openIE-dev/free-humanoid-platform/docs/README.md

# docs/

Additional design documentation beyond the root [README.md](../README.md) and [ARCHITECTURE.md](../ARCHITECTURE.md).

## Status (v0.0)

Stub.

## Planned content

- `building-a-free-humanoid.md` — assembly walkthrough (will be auto-generated in part by OpenLoco's `assembly.md` output, with chassis-specific augmentation)
- `commissioning.md` — first-power-on, calibration, safety supervisor verification
- `safety-and-ethics.md` — extended safety case, regulatory posture, deployment checklists
- `regulatory.md` — jurisdiction-specific notes (EU Machinery Directive, ANSI / ISO 10218, CE marking, FCC for wireless)
- `governance.md` — defensive-publication discipline, contributor norms, foundation structure (TBD)
- `release-runbook.md` — quarterly release ceremony, parallel to corpus quarterly release
- `glossary.md` — abbreviations and terms used across the platform

## License

CC-BY-SA-4.0 (per [../LICENSE-DOCS](../LICENSE-DOCS)).
