openIE-dev/free-humanoid-platform/(commit log)

2026-05-06 scaffold Free Humanoid Platform — the seventeenth OpenLoco morphology
    Initial scaffold positioning the project as the 17th morphology in the
    OpenLoco ecosystem (humanoid_bipedal). Tenant of:
    - OpenLoco — substrate (CC0 UDD descriptor → URDF/MJCF/STL/BOM)
    - Free Humanoid Corpus — 211-entry public-domain prior-art commons
    Includes:
    README.md — positioning, OpenIE family integration, license overlay
    ARCHITECTURE.md — full-system spec citing corpus entries by id;
    §9 enumerates 10 load-bearing TBD architectural calls
    descriptor/free-humanoid.udd.json
    — 40 links / 39 joints / 29 actuator slots / 4 modes,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
2026-05-07 platform: resolve 10 architectural commitments + inline canonical license texts (v0.1)
    Architectural commitments (ARCHITECTURE.md §9):
    1. Actuator distribution: HYBRID — cycloidal hip/knee, harmonic-drive
    shoulder/elbow, QDD ankle, tendon wrist+hand. Each joint shielded
    by its deepest available prior-art chain.
    2. Mass budget: 50 kg reference build. 30 kg / 80 kg as variants.
    3. Default policy: classical MPC + RL locomotion + IL manipulation.
    Full VLA documented as upgrade path.
    4. Default end-effector: 5-finger underactuated synergy-reduced hand.
    Parallel-jaw and Shadow-class as alternative variants.
    5. Depth modality: stereo + GelSight tactile fingertips. A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
2026-05-07 platform: README v0.0 → v0.1 (architectural commitments resolved, licenses inlined, corpus 230 entries)
2026-05-07 platform: hand v0.1 vendor-pinned BOM + assembly + descriptor wiring
    First Phase-1 deliverable per ARCHITECTURE.md §6: the underactuated
    5-finger synergy-reduced hand subassembly committed in §9 #4 and #8.
    Files added:
    chassis/hand-v0.1-BOM.csv — 31 line items, total ~$2,288 USD at
    unit-quantity-1 academic pricing. Real catalog numbers from Maxon,
    mjbots, Misumi, McMaster, Smooth-On, Lee Spring, Phidgets.
    chassis/hand-v0.1-assembly.md — six-phase assembly procedure with
    failure modes and calibration steps.
    chassis/hand-v0.1-cad-references.md — pointers to mechanical CAD
    files (FreeCAD .FCStd, .step, .dxf) we'll produce. ANSI Y14.5 GD&T
    + ISO 286 fits and to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
    [hand-v0.1-BOM.csv]
2026-05-07 platform: hand v0.1 OpenSCAD parametric CAD (10 .scad files)
    Parametric CAD source for the underactuated 5-finger synergy-reduced
    hand committed in §9 #4. Text-based, version-controllable, deterministic,
    renders to STL/DXF via OpenSCAD 2024.05+.
    Files at chassis/cad/:
    hand_params.scad single source of truth (dims, fits, materials,
    BOM cross-references; flags six dimensions for
    physical-build feedback)
    phalanx.scad single phalanx primitive with tendon channel,
    joint barrel, return-spring pocket
    finger.scad composes 3 phalanges (or 2 for thumb)
    palm.scad palm chassis: finger mo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
    [finger.scad, hand_assembly.scad, hand_params.scad, motor_bracket.scad, palm.scad, phalanx.scad, pulley.scad, skin_mold.scad]
2026-05-07 platform: hand v0.1 audit report + leg v0.1 BOM/assembly/OpenSCAD CAD/descriptor
    Two deliverables in one commit (audit and leg subassembly were produced
    by parallel agents).
    Hand v0.1 audit (chassis/hand-v0.1-cad-audit.md):
    Independent CAD-vs-BOM-vs-descriptor cross-check found 9 critical
    fabrication-blocking issues:
    1. Motor bracket bolts to palm at 25 mm BCD; palm has 22 mm BCD
    holes (motor_bracket.scad:30 vs palm.scad:104) — bracket cannot
    mount
    2. Finger and palm MCP barrels perpendicular after rotate([0,0,90])
    in hand_assembly.scad:58 — no shared axle
    3. motor_face_pcd=22 contradicts Maxon GP 32 HP datasheet
    (4×M3 on ~27mm PCD)
    4. 8-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
    [ankle.scad, femur.scad, foot.scad, hip.scad, knee.scad, leg-v0.1-BOM.csv, leg_assembly.scad, leg_params.scad]
2026-05-07 sim: add Genesis as secondary GPU-parallelized simulator
    Genesis (Genesis-Embodied-AI/Genesis, December 2024) is the
    GPU-parallelized open-source unified multi-physics engine published
    Apache-2.0 by a CMU/Stanford/MIT/Tsinghua/Peking/ETH/UMD academic
    collaboration. URDF/MJCF interoperable, so OpenLoco's descriptor
    compiles to it without modification. 43M FPS rigid-body on a single
    RTX 4090; differentiable for gradient-based policy optimization.
    Slotted as secondary (after MuJoCo, ahead of Drake / Gazebo / Isaac)
    because it's the open-permissive sim-to-real-at-scale substrate.
    Corpus citation links the genesis-embodied-ai-simulator entry in
    the contention-packet for control-sim-to-real.
    Co-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
2026-05-07 hand v0.1.1: address 9 critical + 6 significant audit findings
    Critical (9):
    - #1 motor_bracket <-> palm bolt circle aligned at palm_mount_pcd=25
    - #2 finger long axis rebuilt to +Y; rotate([0,0,90]) removed in
    hand_assembly; palm finger_mcp_mount and thumb_cmc_block barrels
    rotated to share an X axis with phalanx barrels
    - #3 Maxon GP 32 HP face: M3 PCD 27 (was M2.5 PCD 22); motor_bracket
    motor-side counterbore Ø5.6 for M3 head
    - #4 palm pulleys reduced from 8-star to 3 routed (spool exit + 2
    distribution); no pivot within 8 mm of motor center
    - #5 spool radius 0.004 m (was 0.008) in descriptor; ~205 N continuous
    / ~1562 N peak rationale recomputed
    - #6 MCP flex now applied to pr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
    [finger.scad, hand-v0.1-BOM.csv, hand_assembly.scad, hand_params.scad, motor_bracket.scad, palm.scad, phalanx.scad]
2026-05-07 hand v0.1.1: add build runbook (pre-order verify, vendor sequencing, 6-stage bench test)
    Closes the loop from v0.1.1 paper-fix to first physical build. Sections:
    - Pre-order verification gate (Maxon face, Misumi flange, dowel, bushing)
    - 3-tier vendor sequencing (Maxon 4-6 wk, mjbots 1-2 wk, McMaster JIT)
    - Pre-fab CAD prep with PLA desktop sanity check before SLS
    - Receive-and-inspect checklist per vendor batch
    - 6-stage bench test (motor spin -> single finger -> 5-finger manual ->
    motor synergy -> tension loop -> 24-hr cycle soak)
    - Feedback capture spec for v0.1.2 (descriptor <-> physical loop)
    - Known-risk register (audit-deferred + new physical-build risks)
    The runbook is the artif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
2026-05-07 hand v0.1.1: wire openie-cad parse+UDD verifier as the canonical CAD check
    All 9 v0.1.1 .scad files PASS via openie-cad (cad.openie.dev) check_openscad
    example: every file lexes, parses, and imports to UDD without semantic
    error. Stronger than brace/paren balancing.
    Build runbook §3.1 now calls the openie-cad verification before STL render
    as the canonical CAD-check step. The OpenSCAD render step in §3.2 is
    preserved (Homebrew openscad deprecated 2026-09-01; nightly build is
    the path until openie-cad's CSG kernel exposes a CLI render).
    hand-v0.1.1-fixes.md captures the v0.1.1 baseline result with body/UDD-
    node counts and links to the verifier source. Re-run before any future
    CAD edit; e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
2026-05-08 hand v0.1.2: address 6 deferred audit items + invariant assertions
    #12 palm routing topology validated and documented (50-line topology
    comment block + per-leg distance / wrap-angle / motor-mount
    clearance check)
    #13 palm tendon distribution channel limited from full ~90mm to actual
    ~30mm cable run — restores PA12 wall thickness in unused region
    #15 Misumi MBPB8-3-2 pulley flange thickness 0.6 → 1.0 mm (matches
    datasheet 1+2+1 = 4mm stack)
    #16 skin mold proxy explicitly documented as v0.1.x intermediate;
    v0.2 minkowski rebuild plan documented in skin_mold.scad header
    #17 skeleton-registration peg + matching captive hole added at wrist
    coupler — keeps skeleton centered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
    [hand_params.scad, palm.scad, phalanx.scad, pulley.scad, skin_mold.scad]
